trimixtimo/projektarbeit/Matlab/niedrigeAbtastrate.jpg

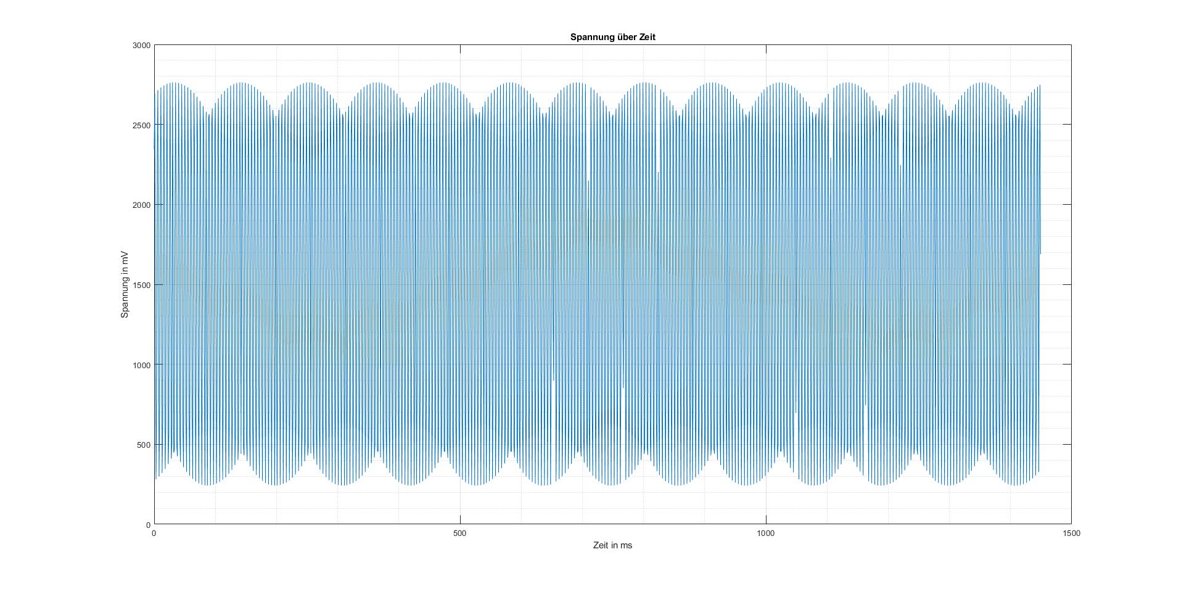
Matlab/niedrigeAbtastrate.jpg
