trimixtimo/projektarbeit/Bilder/20220428_145933642_iOS.jpg

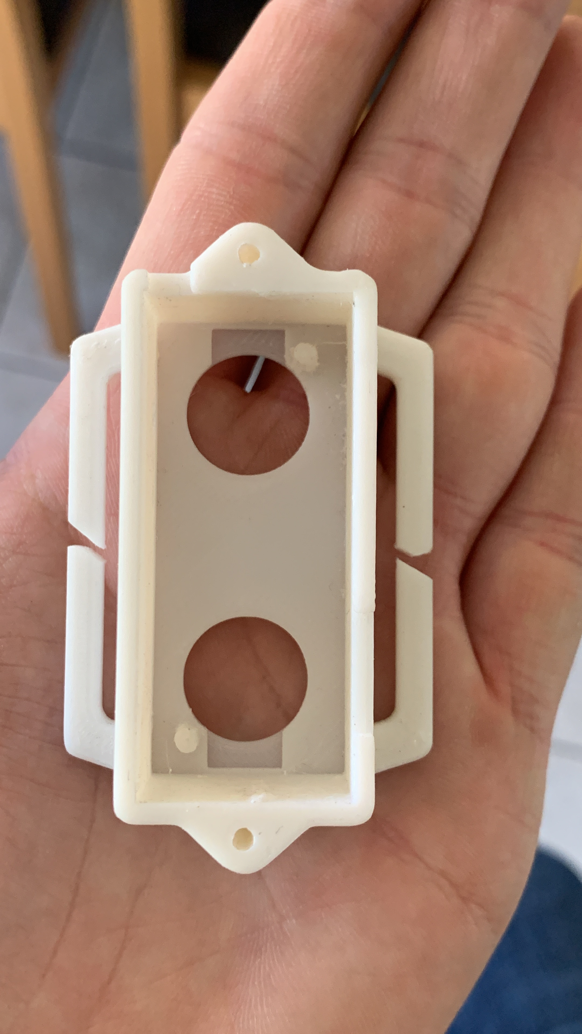
Bilder/20220428_145933642_iOS.jpg
