trimixtimo/projektarbeit/Bilder/ansicht_seitlich (3).png

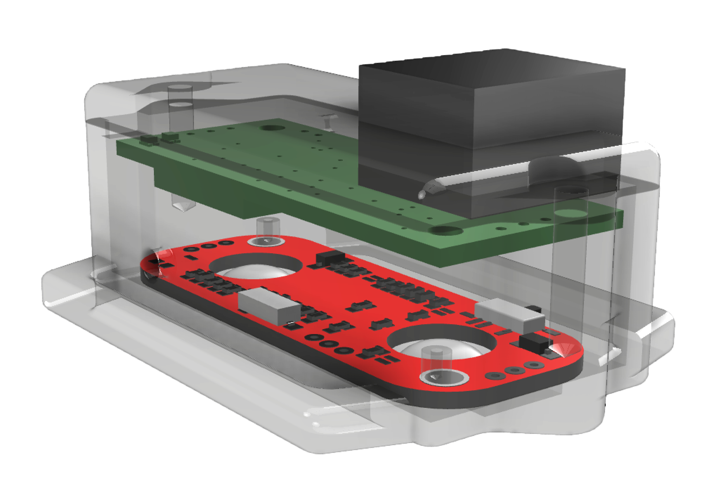
Bilder/ansicht_seitlich (3).png
