trimixtimo/projektarbeit/Elektronik/stabileVersorgungsspannungBild2.png

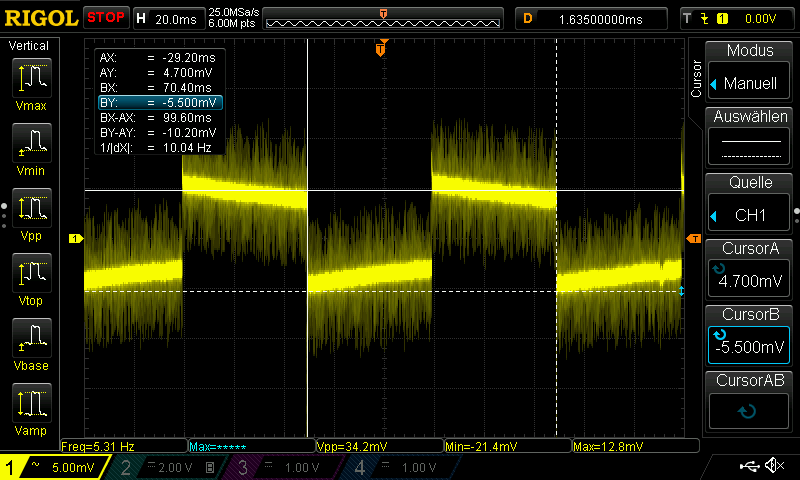
Elektronik/stabileVersorgungsspannungBild2.png
