trimixtimo/projektarbeit/Matlab/hoheAbtastrate.jpg

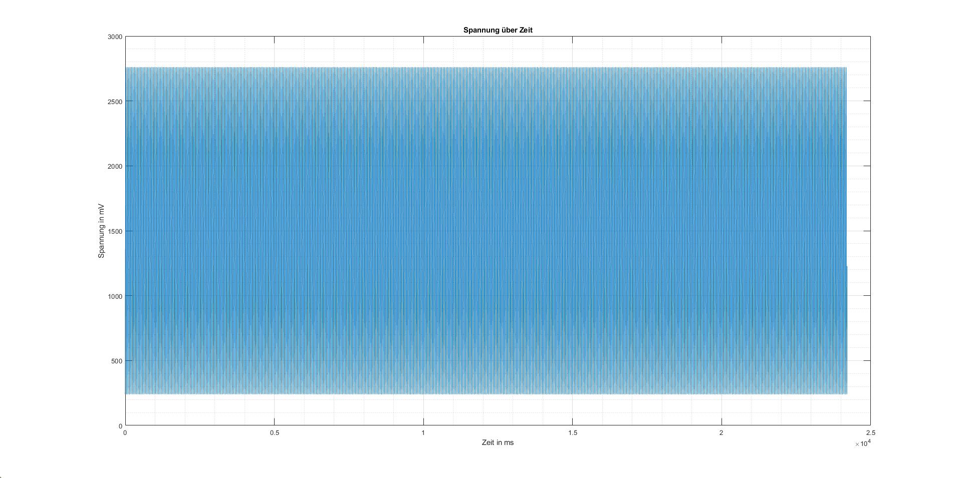
Matlab/hoheAbtastrate.jpg
