trimixtimo/projektarbeit/Matlab/hoheAbtastrate_Detail.jpg

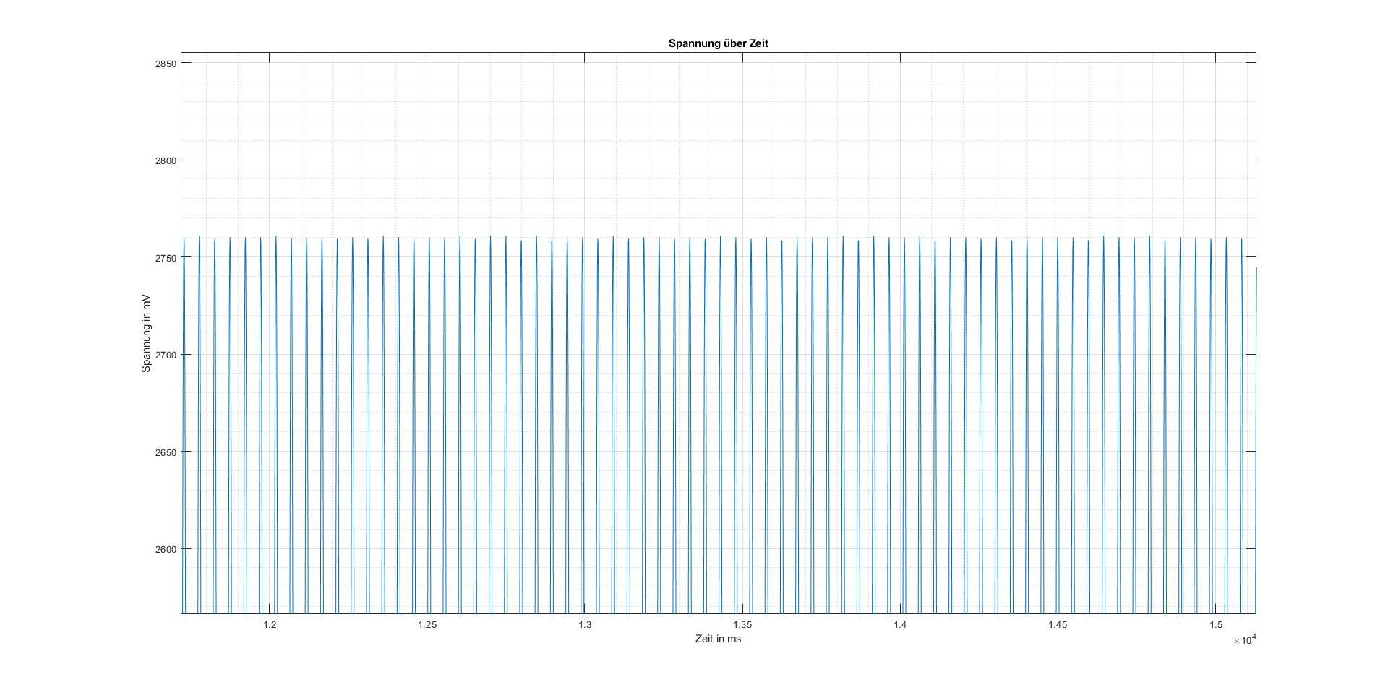
Matlab/hoheAbtastrate_Detail.jpg
