trimixtimo/projektarbeit/Matlab/niedrigeAbtastrate_Detail.jpg

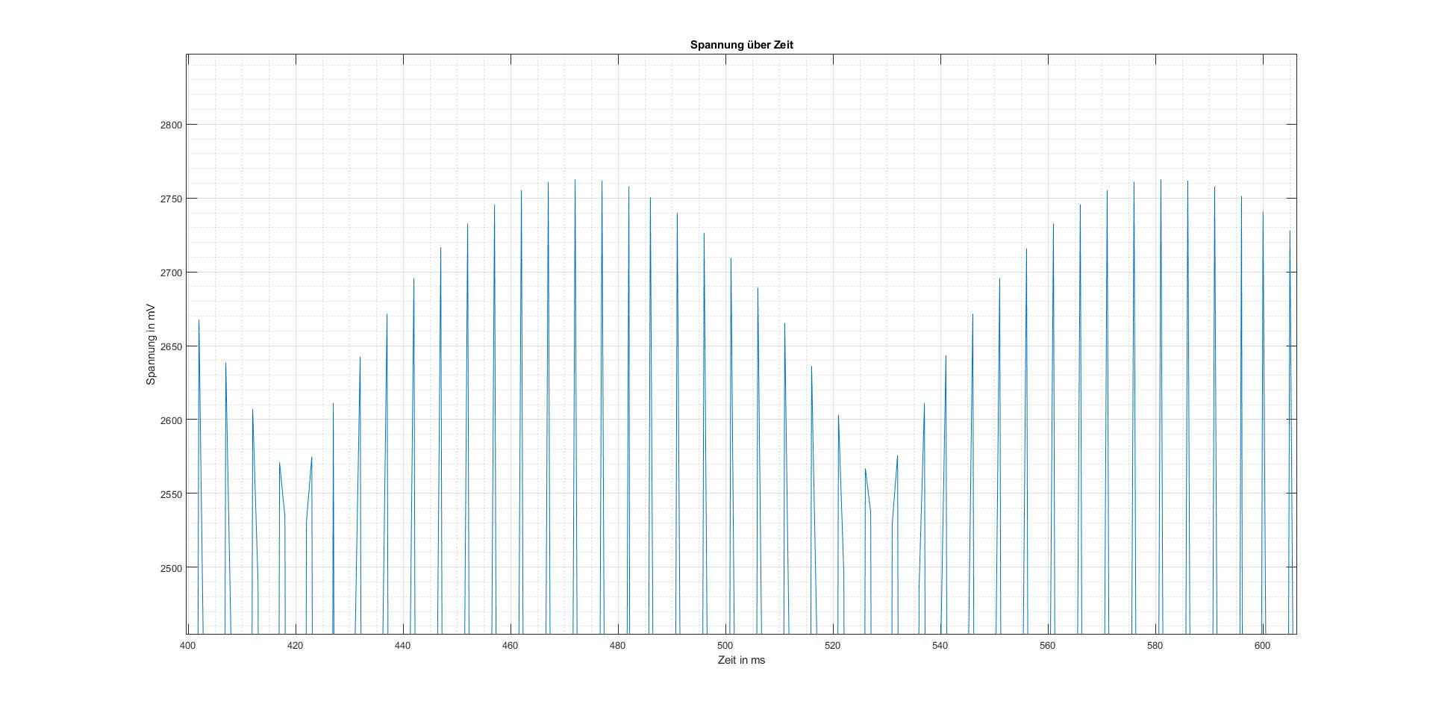
Matlab/niedrigeAbtastrate_Detail.jpg
