trimixtimo/projektarbeit/Elektronik/Filter_sim.pdf

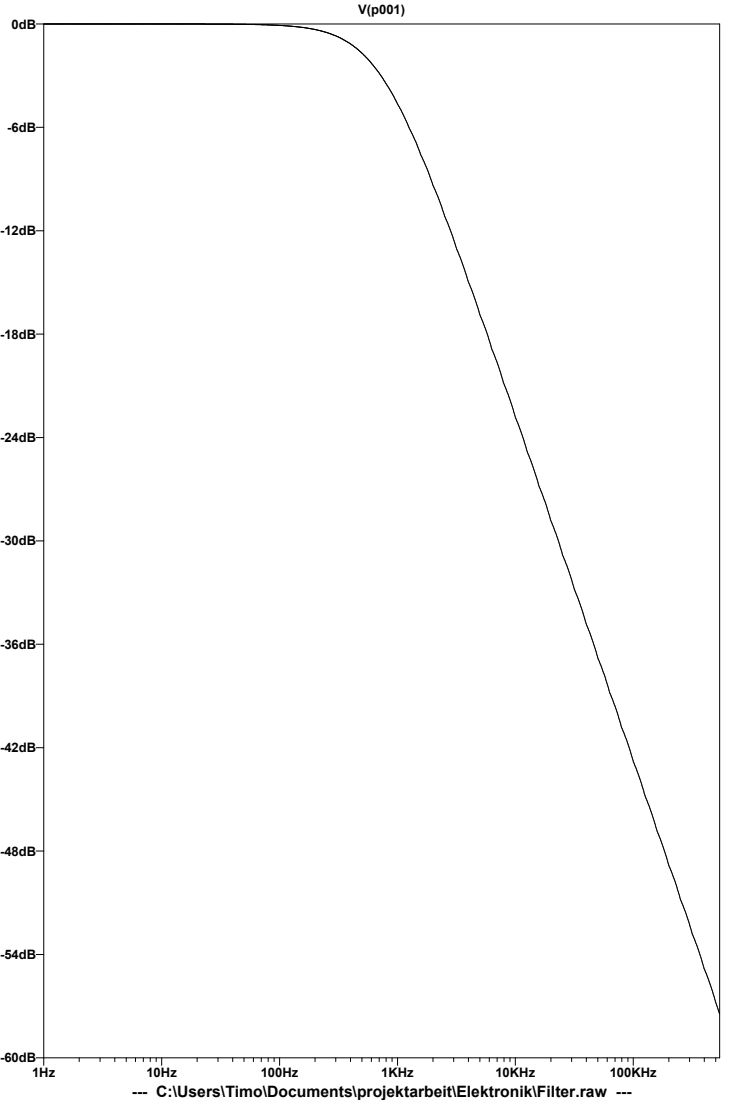
[picture p9: page 1]
1KHz; 10KHz; 100KHz

--- C:\Users\Timo\Documents\projektarbeit\Elektronik\Filter.raw ---
