trimixtimo/projektarbeit/Elektronik/eagle/Projektarbeit_parts_top.pdf

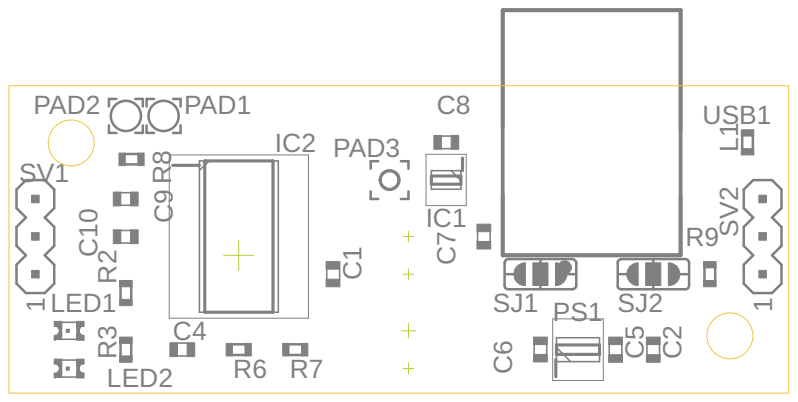
[picture p10: page 1]
