trimixtimo/projektarbeit/Elektronik/Größenvergleich.pdf

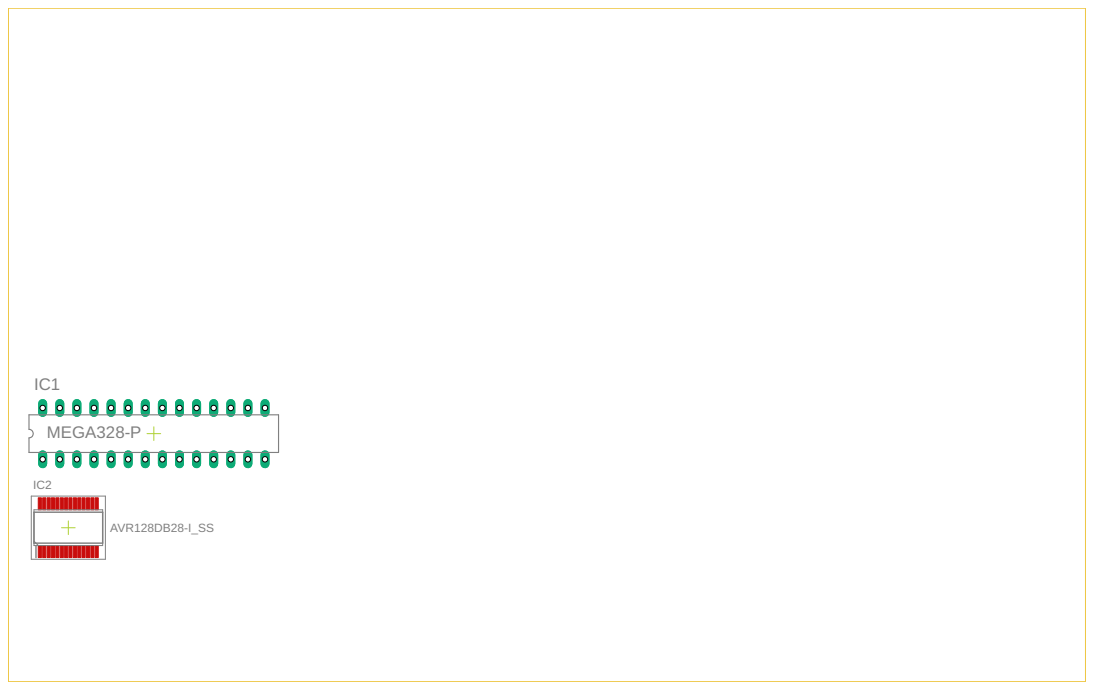
[picture p11: page 1]
