trimixtimo/projektarbeit/Elektronik/Platine.pdf

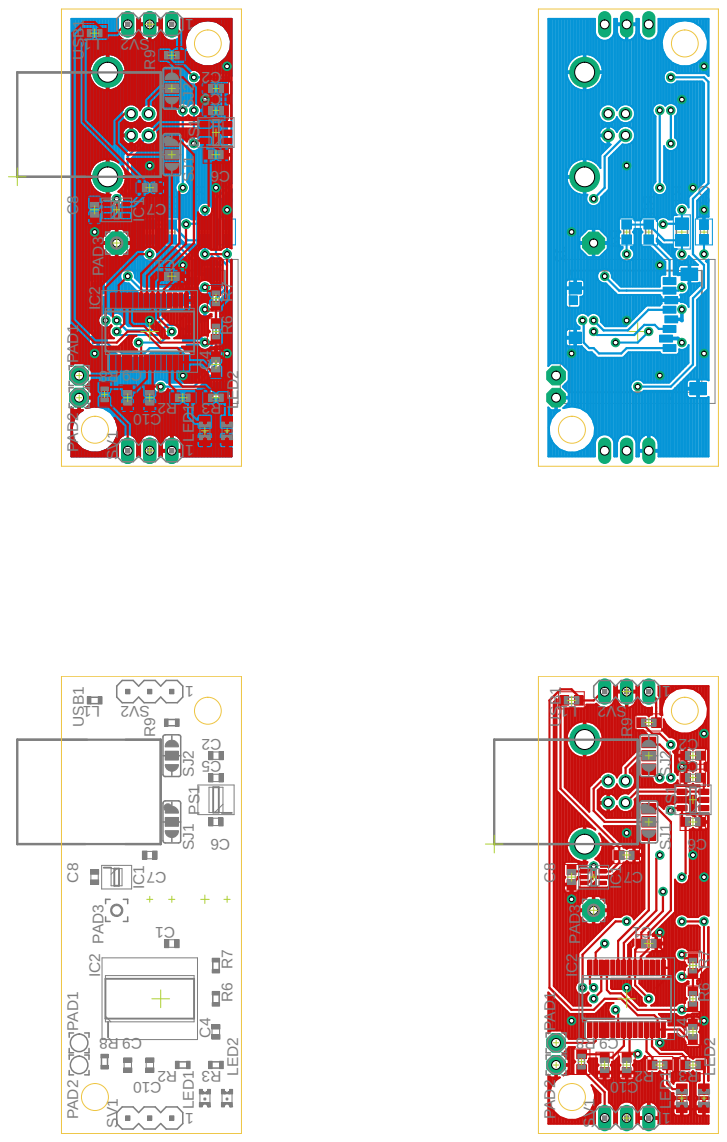
[picture p12: page 1]
