trimixtimo/projektarbeit/Elektronik/Schaltplan.pdf

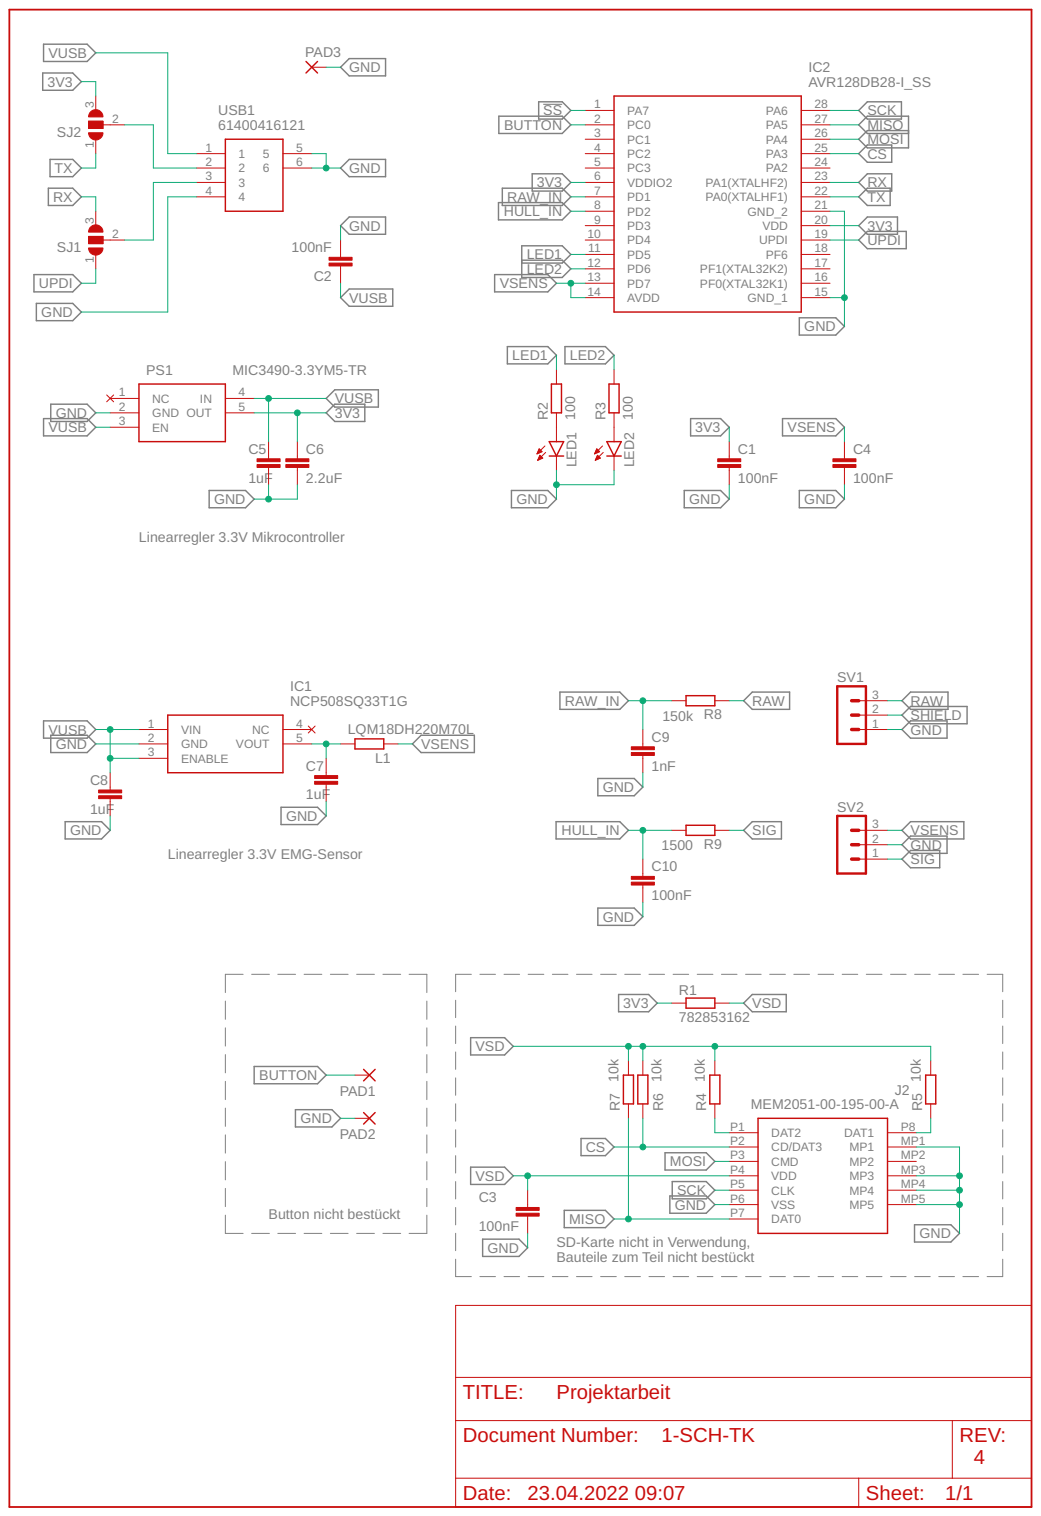
[picture p13: page 1]

MISO
SD-Karte nicht in Verwendung, Bauteile zum Teil nicht bestückt

Document Number: 1-SCH-TK | REV: 4

Date: 23.04.2022 09:07 | Sheet: 1/1
