trimixtimo/projektarbeit/Elektronik/eagle/Board_V2.pdf

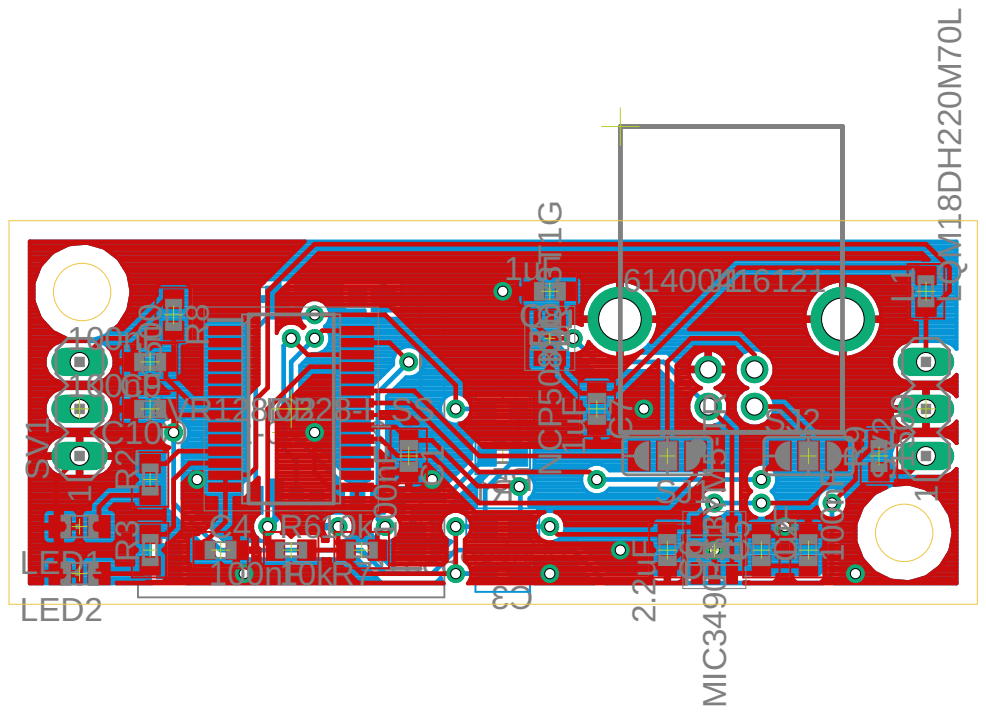
[picture p14: page 1]
