trimixtimo/projektarbeit/Elektronik/eagle/Projektarbeit.pdf

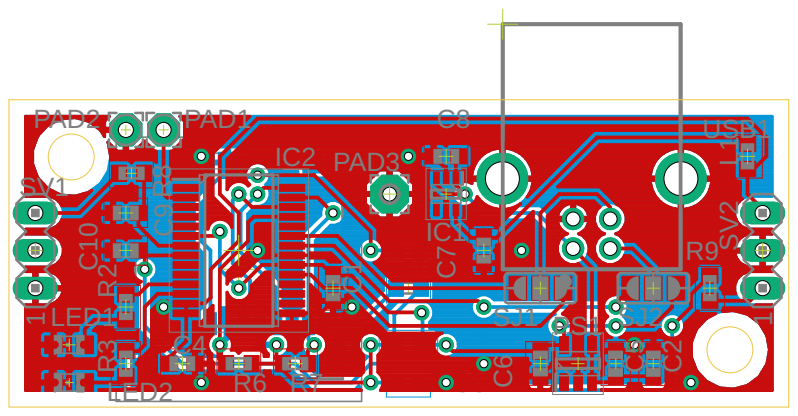
[picture p15: page 1]
