trimixtimo/projektarbeit/Elektronik/eagle/Projektarbeit_bottom.pdf

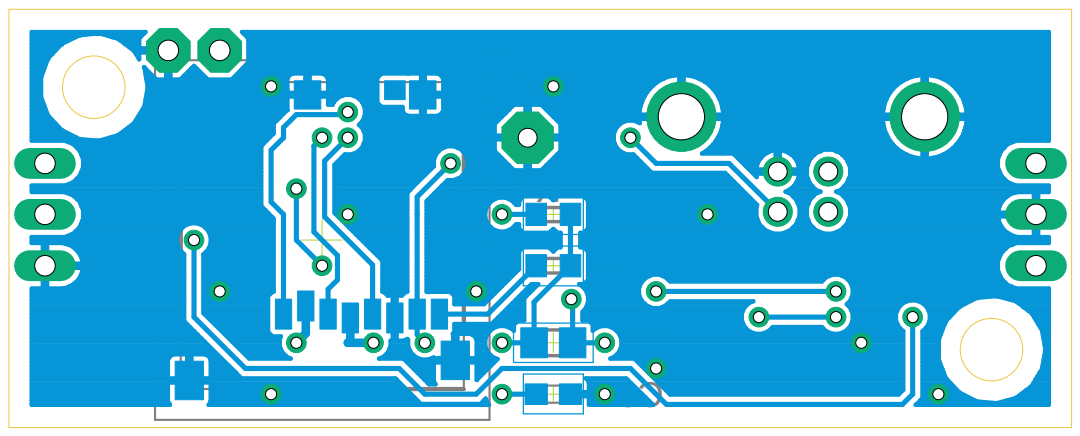
[picture p16: page 1]
