trimixtimo/projektarbeit/Elektronik/eagle/Projektarbeit_top.pdf

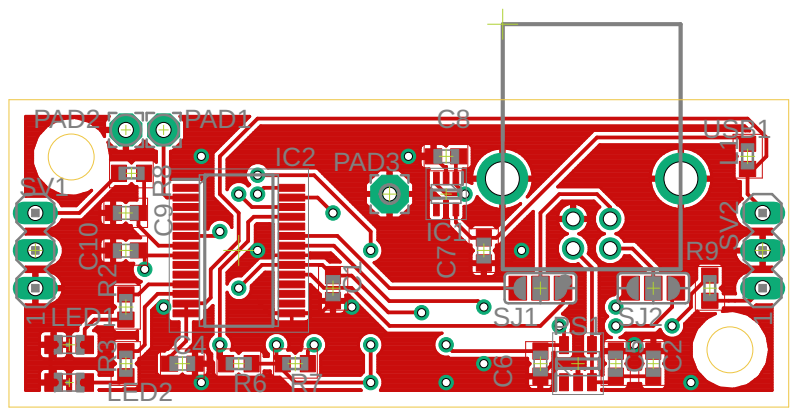
[picture p17: page 1]
