trimixtimo/projektarbeit/Elektronik/eagle/Schaltplan_V2.pdf

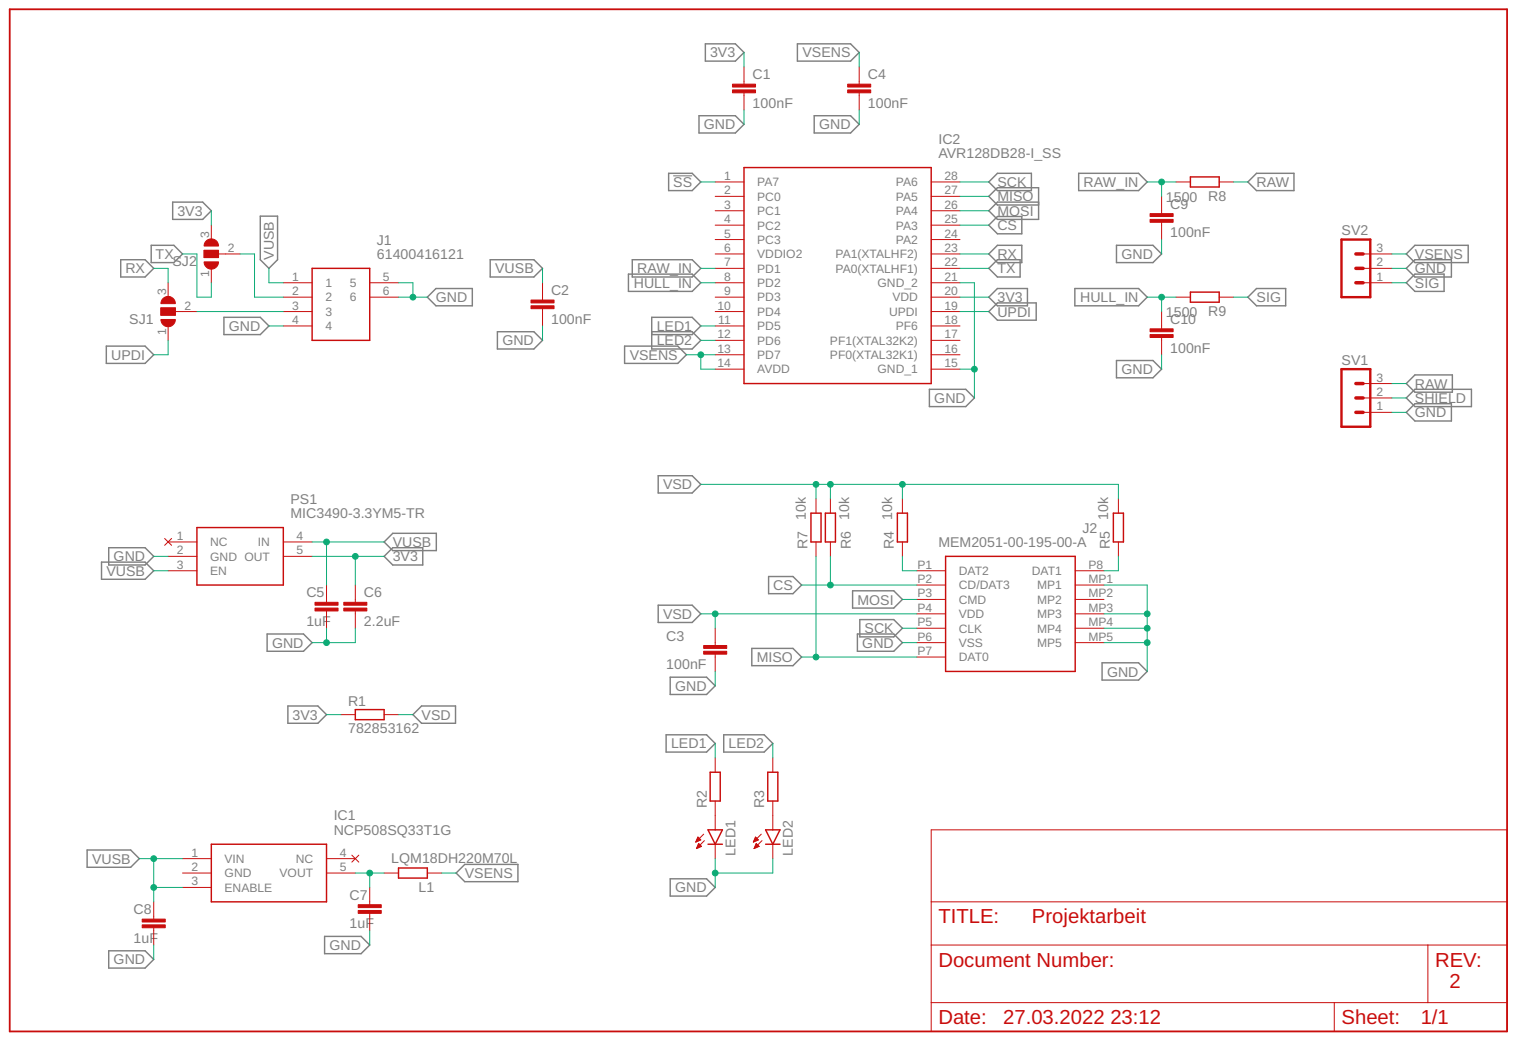
[picture p18: page 1]

Document Number: | REV: 2

Date: 27.03.2022 23:12 | Sheet: 1/1
