trimixtimo/projektarbeit/Elektronik/eagle/Schaltplan_V1.pdf

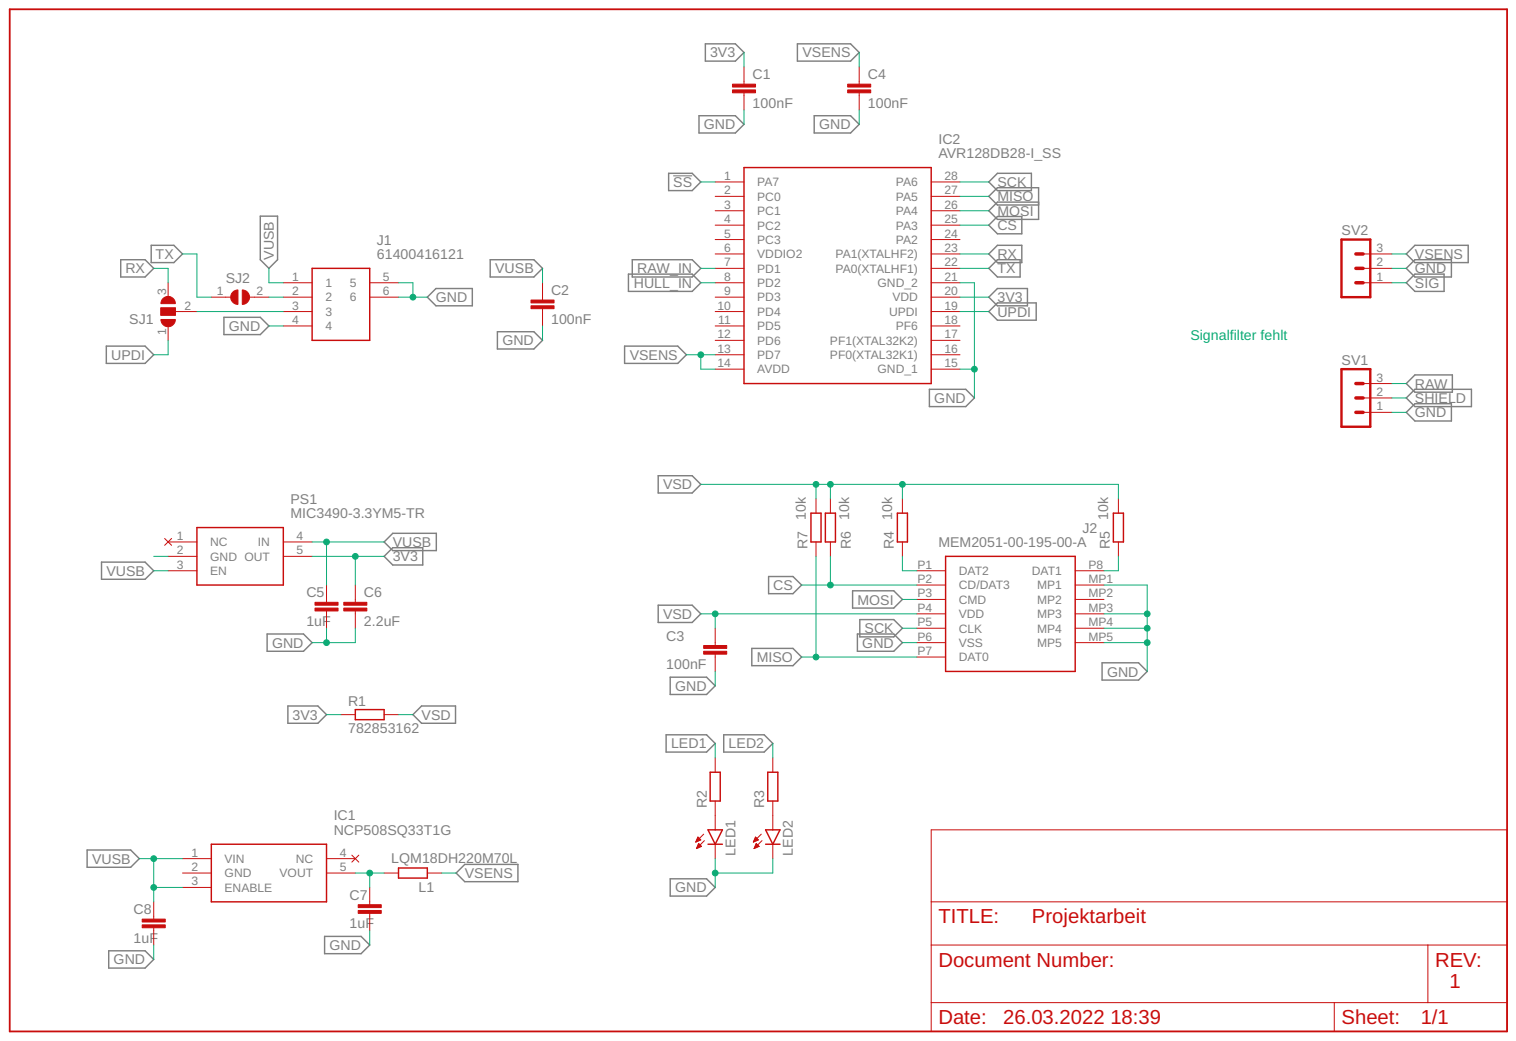
[picture p19: page 1]

Document Number: | REV: 1

Date: 26.03.2022 18:39 | Sheet: 1/1
