trimixtimo/projektarbeit/Elektronik/Filter.asc

C1: cap; 2.2µ
R1: res; 100
V1: voltage; ""; AC 1
Named nets: 0
.ac dec 10 1 540000
