trimixtimo/projektarbeit/Elektronik/eagle/Projektarbeit.brd

## EAGLE design Elektronik/eagle/Projektarbeit.brd (2022-04-23)

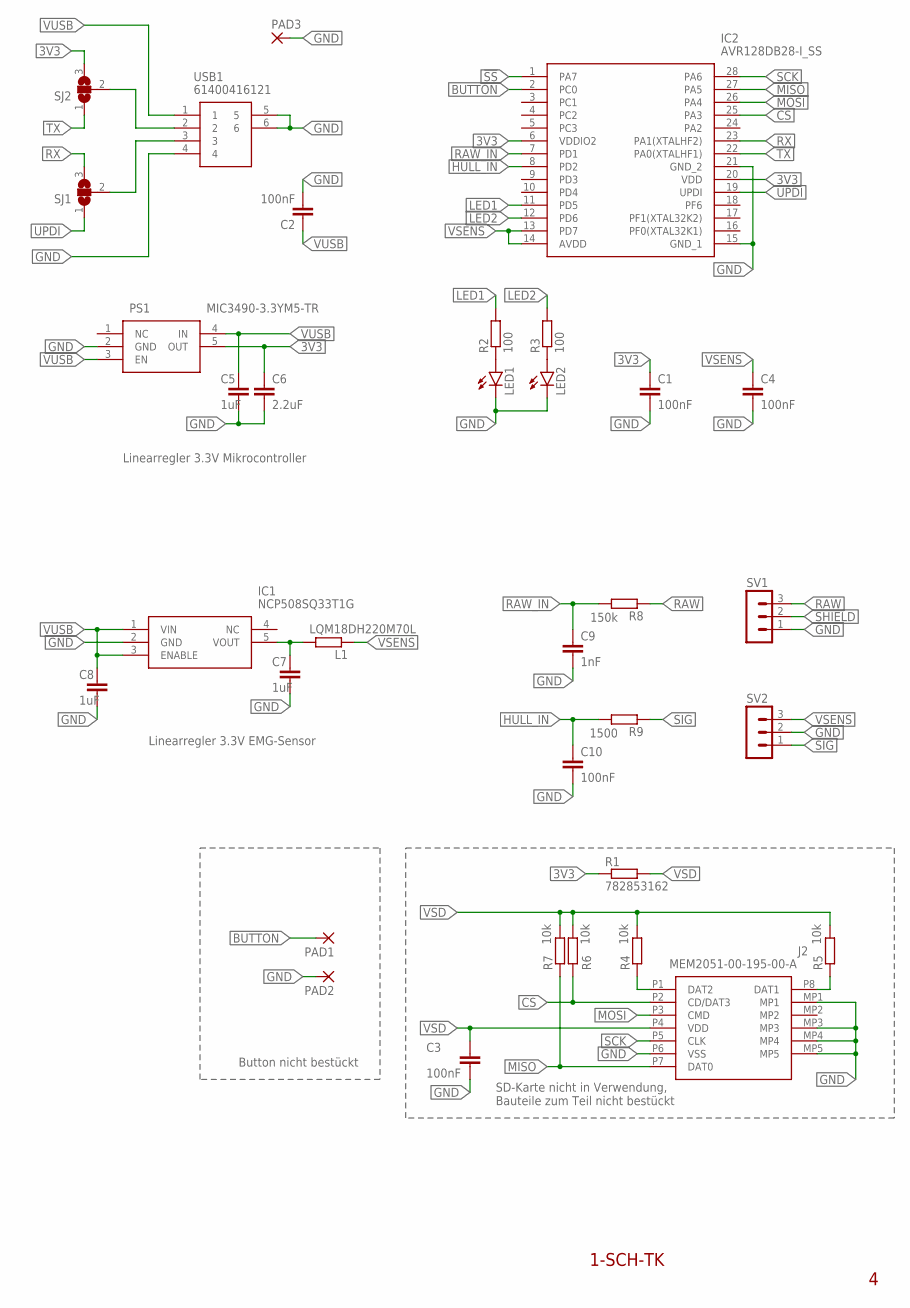
[picture p20: schematic Projektarbeit.sch]

Parts:
C1, C2, C3, C4, C10: 100nF; C0603
C5, C7, C8: 1uF; C0603
C6: 2.2uF; C0603
C9: 1nF; C0603
IC1: NCP508SQ33T1G; SOT65P210X110-5N
IC2: AVR128DB28-I_SS; SOP65P780X200-28N
J2: MEM2051-00-195-00-A; MEM20510019500A
L1: LQM18DH220M70L; R0603
LED1, LED2: LEDCHIPLED_0805; CHIPLED_0805
PAD1, PAD2: 2,15/1,0
PAD3: 2,54/0,9
PS1: MIC3490-3.3YM5-TR; SOT95P280X145-5N
R1: 782853162; R0805
R2, R3: 100; R0603
R4, R5, R6, R7: 10k; R0603
R8: 150k; R0603
R9: 1500; R0603
SJ1, SJ2: SJ2W; SJ_2
SV1, SV2: MA03-1
USB1: 61400416121

Connections:
3V3: C1.1, C6.1, IC2.6 (VDDIO2), IC2.20 (VDD), PS1.5 (OUT), R1.1, SJ2.3
!SS: IC2.1 (PA7)
BUTTON: IC2.2 (PC0), PAD1.1
CS: IC2.25 (PA3), J2.P2 (CD/DAT3), R6.1
GND: C1.2, C2.2, C3.2, C4.2, C5.2, C6.2, C7.2, C8.2, C9.2, C10.2, IC1.2 (GND), IC2.15 (GND_1), IC2.21 (GND_2), J2.MP1, J2.MP3, J2.MP4, J2.MP5, J2.P6 (VSS), LED1.C, LED2.C, PAD2.1, PAD3.1, PS1.2 (GND), SV1.1, SV2.2, USB1.4, USB1.5, USB1.6
HULL_IN: C10.1, IC2.8 (PD2), R9.2
LED1: IC2.11 (PD5), R2.2
LED2: IC2.12 (PD6), R3.2
MISO: IC2.27 (PA5), J2.P7 (DAT0), R7.1
MOSI: IC2.26 (PA4), J2.P3 (CMD)
unnamed: SJ1.2, USB1.3
unnamed: SJ2.2, USB1.2
unnamed: C7.1, IC1.5 (VOUT), L1.2
unnamed: LED1.A, R2.1
unnamed: J2.P1 (DAT2), R4.1
unnamed: J2.P8 (DAT1), R5.1
unnamed: LED2.A, R3.1
RAW: R8.1, SV1.3
RAW_IN: C9.1, IC2.7 (PD1), R8.2
RX: IC2.23 (PA1(XTALHF2)), SJ1.3
SCK: IC2.28 (PA6), J2.P5 (CLK)
SHIELD: SV1.2
SIG: R9.1, SV2.1
TX: IC2.22 (PA0(XTALHF1)), SJ2.1
UPDI: IC2.19 (UPDI), SJ1.1
VSD: C3.1, J2.P4 (VDD), R1.2, R4.2, R5.2, R6.2, R7.2
VSENS: C4.1, IC2.13 (PD7), IC2.14 (AVDD), L1.1, SV2.3
VUSB: C2.1, C5.1, C8.1, IC1.1 (VIN), IC1.3 (ENABLE), PS1.3 (EN), PS1.4 (IN), USB1.1

Notes on the sheet:
SD-Karte nicht in Verwendung, Bauteile zum Teil nicht bestückt
Button nicht bestückt
Linearregler 3.3V EMG-Sensor
Linearregler 3.3V Mikrocontroller
1-SCH-TK

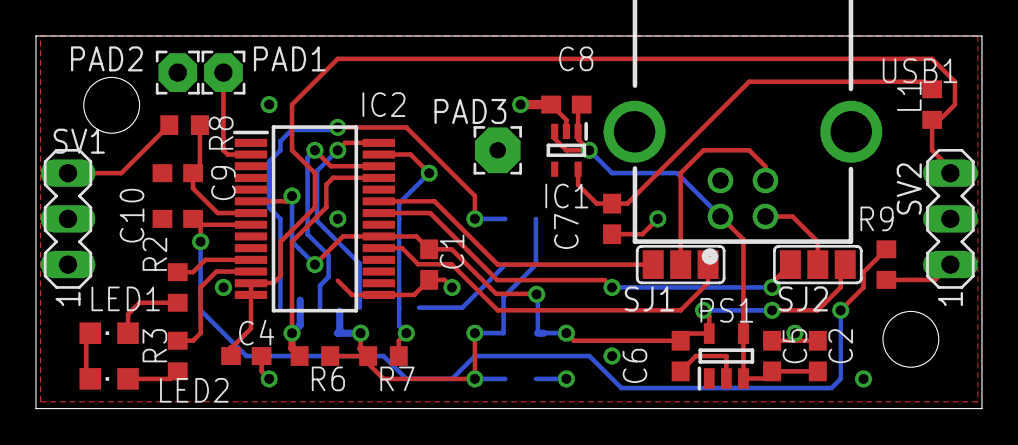
[picture p21: board Projektarbeit.brd from above]

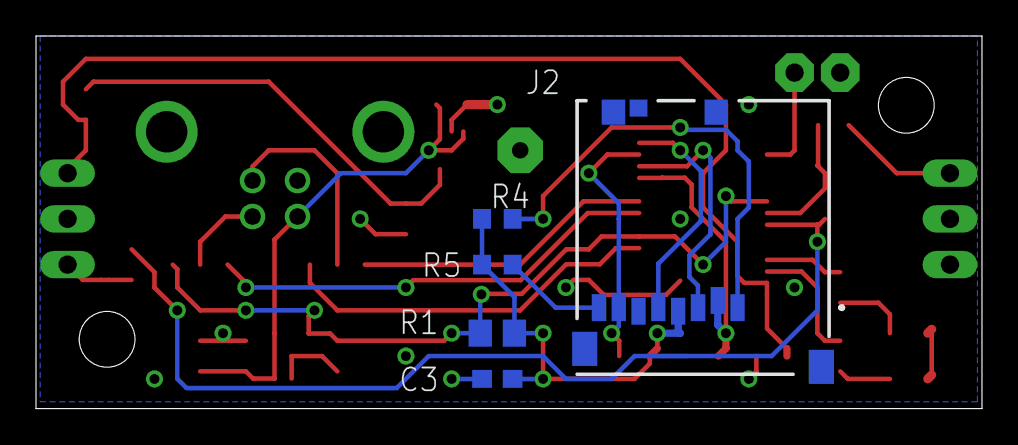
[picture p22: board Projektarbeit.brd from below]

Board: 2 copper layers, 52.6 x 20.7 mm, 34 parts (5 on the bottom side), 26 nets.
