trimixtimo/projektarbeit/ArduinoCode/AnalogInOutSerial/AnalogInOutSerial.ino

/*
  Analog input, analog output, serial output

  Reads an analog input pin, maps the result to a range from 0 to 255 and uses
  the result to set the pulse width modulation (PWM) of an output pin.
  Also prints the results to the Serial Monitor.

  The circuit:
  - potentiometer connected to analog pin 0.
    Center pin of the potentiometer goes to the analog pin.
    side pins of the potentiometer go to +5V and ground
  - LED connected from digital pin 9 to ground through 220 ohm resistor

  created 29 Dec. 2008
  modified 9 Apr 2012
  by Tom Igoe

  This example code is in the public domain.

  https://www.arduino.cc/en/Tutorial/BuiltInExamples/AnalogInOutSerial
*/

// These constants won't change. They're used to give names to the pins used:
const int analogInPin = A0;  // Analog input pin that the potentiometer is attached to
int sensorValue = 0;        // value read from the pot

void setup() {
  // initialize serial communications at 9600 bps:
  Serial.begin(57600);
  pinMode(LED_BUILTIN, OUTPUT);
}

void loop() {
  sensorValue = analogRead(analogInPin);
  sensorValue = sensorValue * 4;
  Serial.println(sensorValue, HEX);
  delayMicroseconds(620);
  digitalWrite(LED_BUILTIN, 1);
  delayMicroseconds(200);
  digitalWrite(LED_BUILTIN, 0);
}
