trimixtimo/projektarbeit/PythonCode/skriptLinus/serialConnection.py

import serial

#Configure Serial Port
serialPort = serial.Serial(
    port = "COM4",
    baudrate = 500000,
    rtscts = False,
    bytesize = 8,
    timeout = 0,
    write_timeout = 0
)
serialPort.flushInput()
