trimixtimo/projektarbeit/(commit log)

2022-03-30 Eagle Files
    [Projektarbeit.brd, Projektarbeit.sch]
2022-03-30 Testprogramm blinkende LED fertiggestellt
2022-03-30 ADC Funktionen hinzugefügt
2022-03-30 Timer-Setup hinzugefügt
2022-04-01 Arduino Code zum testen
2022-04-01 /automatische Auswahl des Ordners 'Messungen'
2022-04-01 funktionstüchtige LED-Firmware mit Reaktion auf Schalterstellung
2022-04-01 Neues Projekt für Hauptfirmware, LED Firmware auf notwendigsten Inhalt reduziert
2022-04-01 Funktionen zum starten und stoppen von TimerA0
2022-04-01 ISR für TimerA0 hinzugefügt
2022-04-01 Änderungen der Register markiert
2022-04-05 FatFS Dateisystem Lib und Beispiele
    [mkfs.xlsx]
2022-04-05 uart initialisierung
2022-04-05 Code umbau auf uart
2022-04-05 Fehler in main behoben, laufende messung wird nun gesetzt
    [main.c]
2022-04-05 fertiger Code für Messung mit Schalter und Uart TX
2022-04-06 10Hz Messung
2022-04-08 code umgebaut auf variablen für hüll + leds
2022-04-08 Baudrate und Takt erhöht. Nun Messung mit 100us Abtastrate möglich
2022-04-08 ADC Takt und Sample-Dauer verlängert für bessere Ergebnisse
2022-04-08 Funktion für Umschalten zwischen Hull und Raw ergänzt
2022-04-08 starten und stoppen von Messungen über den PC, Umschalten von Raw zu Hull über den PC. Inklisove zwei Testmessungen mit den neuen Features und AMbu Elektroden
2022-04-10 Erste Messungen
    [200Hz_Sinus_Bild4_diff8.txt]
2022-04-23 veraltete Eagle Dateien gelöscht
    [Projektarbeit.brd, Projektarbeit.sch]
2022-04-23 aktuelle Eagle Dateien in Elektronik abgelegt
    [Projektarbeit.brd, Projektarbeit.sch]
2022-04-27 Änderungen an der Firmware
2022-04-29 Arbeit an der Firmware
2022-05-01 Größenvergleich Arduino vs AVR128
2022-05-01 MEssdaten und Simulation des Rohdaten Filters
    [Filter_real.xlsx]
2022-05-11 Messungen Timo und Testmessungen
