trimixtimo/projektarbeit/Bilder/20220429_091920317_iOS.jpg

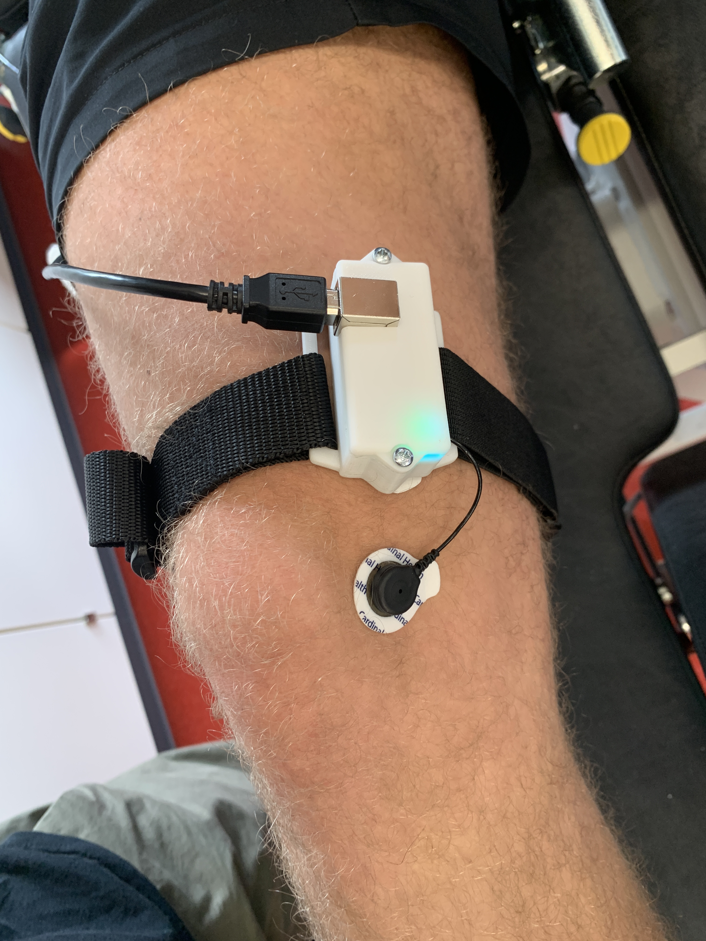
Bilder/20220429_091920317_iOS.jpg
